lflaherty/evfirmware-vcu/hardware/PCB_Layers/ECU_brd_layer1.pdf

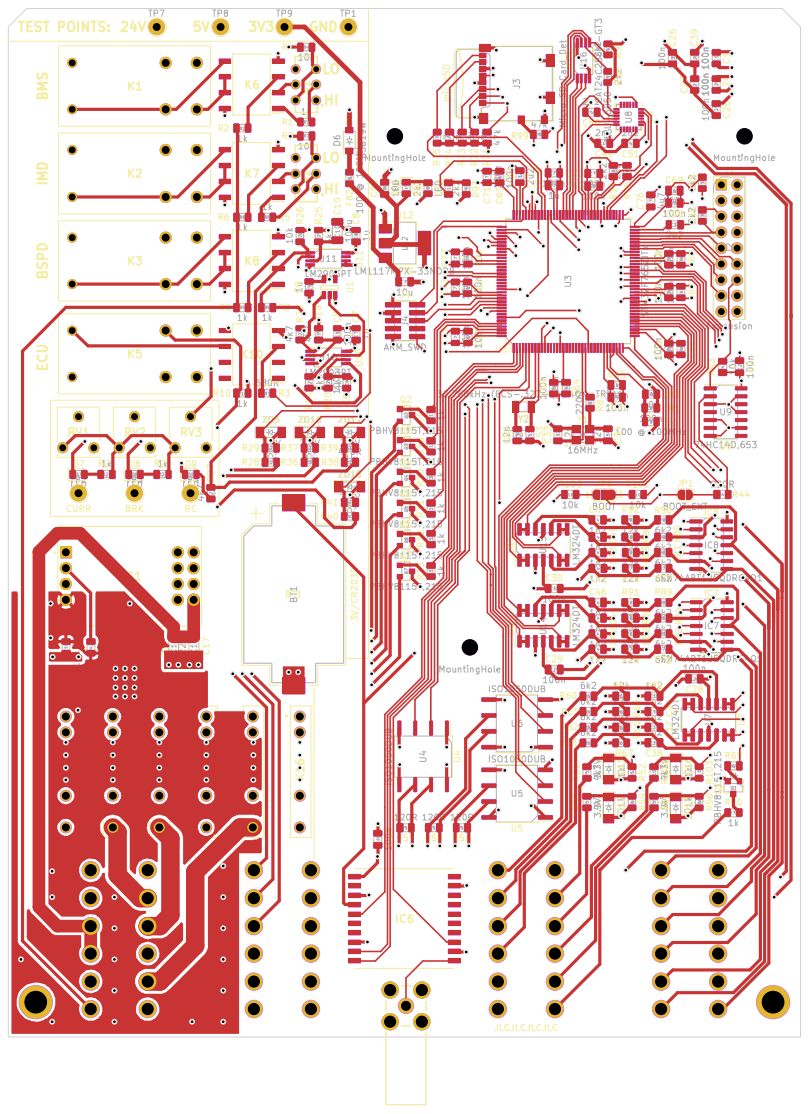
[picture p50: page 1]
