lflaherty/evfirmware-vcu/hardware/PCB_Layers/ECU_brd_layer2.pdf

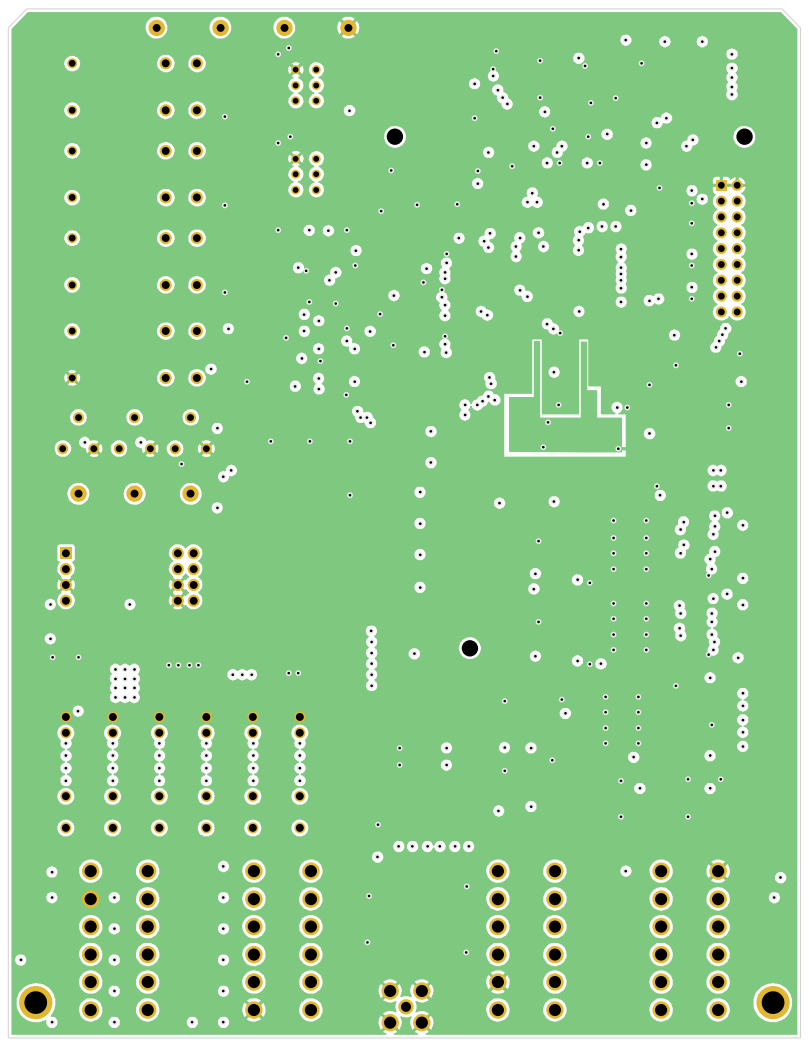
[picture p51: page 1]
