lflaherty/evfirmware-vcu/hardware/PCB_Layers/ECU_brd_layer3.pdf

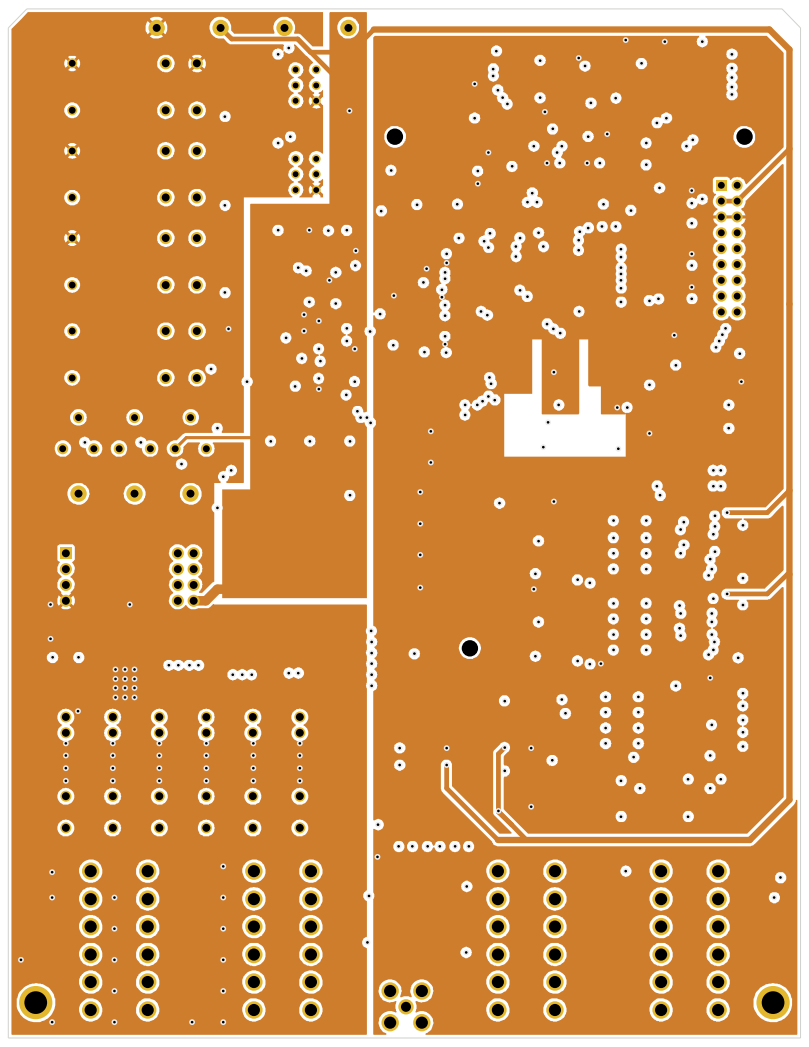
[picture p52: page 1]
