lflaherty/evfirmware-vcu/hardware/PCB_Layers/ECU_brd_layer4.pdf

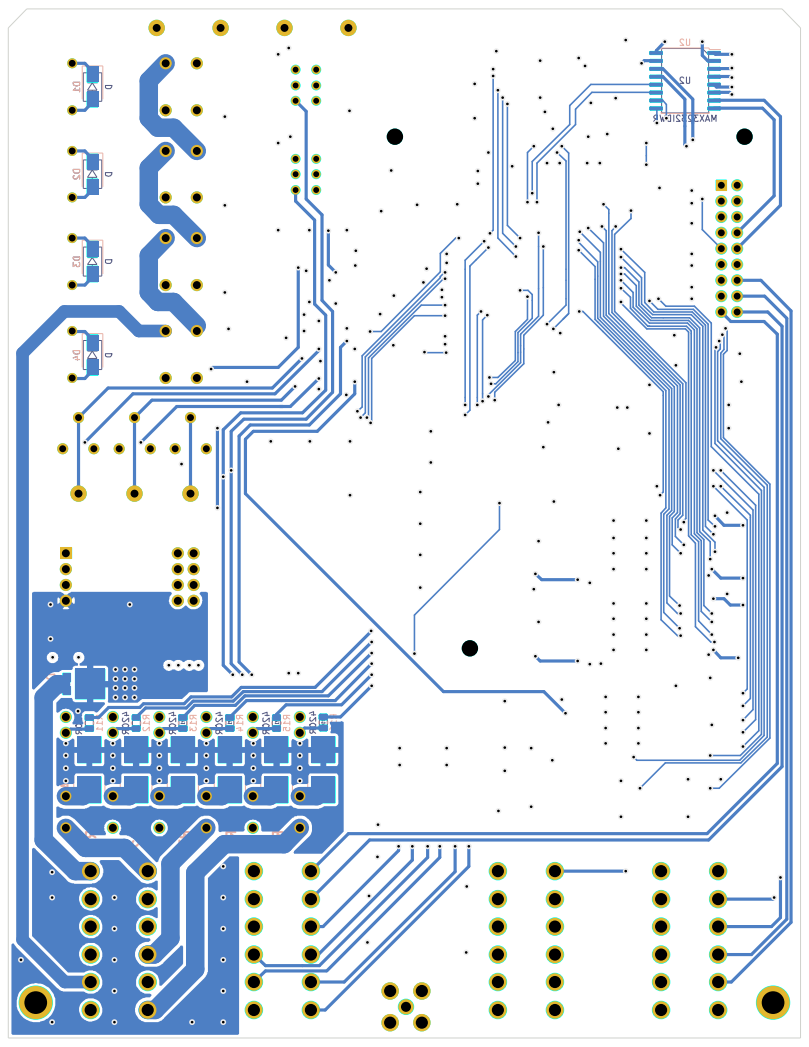
[picture p53: page 1]
