lflaherty/evfirmware-vcu/hardware/PCB_Layers/ECU_brd_combined.pdf

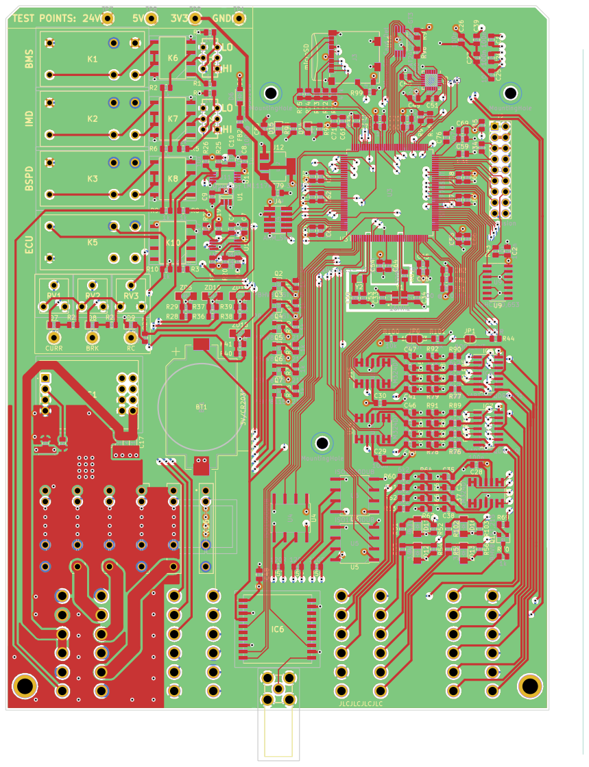
[picture p54: page 1]
