lflaherty/evfirmware-vcu/firmware/src/hal/stm32f767/Core/Src/main.c

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
/* Includes ------------------------------------------------------------------*/
#include "main.h"

/* USER CODE BEGIN Includes */
#include <stdio.h>
#include <stdbool.h>
#include "FreeRTOS.h"
#include "task.h"

#include "startup/initialize.h"

#include "logging/logging.h"

/* USER CODE END Includes */

ADC_HandleTypeDef hadc1;
DMA_HandleTypeDef hdma_adc1;

CAN_HandleTypeDef hcan1;
CAN_HandleTypeDef hcan2;
CAN_HandleTypeDef hcan3;

CRC_HandleTypeDef hcrc;

I2C_HandleTypeDef hi2c2;
I2C_HandleTypeDef hi2c4;
DMA_HandleTypeDef hdma_i2c2_tx;
DMA_HandleTypeDef hdma_i2c2_rx;

RTC_HandleTypeDef hrtc;

TIM_HandleTypeDef htim2;
TIM_HandleTypeDef htim3;

UART_HandleTypeDef huart1;
UART_HandleTypeDef huart3;
UART_HandleTypeDef huart6;
DMA_HandleTypeDef hdma_usart1_rx;
DMA_HandleTypeDef hdma_usart1_tx;
DMA_HandleTypeDef hdma_usart3_rx;
DMA_HandleTypeDef hdma_usart3_tx;
DMA_HandleTypeDef hdma_usart6_rx;
DMA_HandleTypeDef hdma_usart6_tx;

/* USER CODE BEGIN PV */
static InitData_T initData;
/* USER CODE END PV */

void SystemClock_Config(void);
static void MX_GPIO_Init(void);
static void MX_ADC1_Init(void);
static void MX_CAN1_Init(void);
static void MX_CAN2_Init(void);
static void MX_CAN3_Init(void);
static void MX_I2C4_Init(void);
static void MX_USART1_UART_Init(void);
static void MX_USART3_UART_Init(void);
static void MX_I2C2_Init(void);
static void MX_USART6_UART_Init(void);
static void MX_RTC_Init(void);
static void MX_DMA_Init(void);
static void MX_TIM2_Init(void);
static void MX_CRC_Init(void);
static void MX_TIM3_Init(void);
/**
  * @brief  The application entry point.
  * @retval int
  */
int main(void)
{
  /* MCU Configuration--------------------------------------------------------*/

  /* Reset of all peripherals, Initializes the Flash interface and the Systick. */
  HAL_Init();

  /* Configure the system clock */
  SystemClock_Config();

  /* Initialize all configured peripherals */
  MX_GPIO_Init();
  MX_ADC1_Init();
  MX_CAN1_Init();
  MX_CAN2_Init();
  MX_CAN3_Init();
  MX_I2C4_Init();
  MX_USART1_UART_Init();
  MX_USART3_UART_Init();
  MX_I2C2_Init();
  MX_USART6_UART_Init();
  MX_RTC_Init();
  MX_DMA_Init();
  MX_TIM2_Init();
  MX_CRC_Init();
  MX_TIM3_Init();
  /* USER CODE BEGIN 2 */

  printf("\n");
  printf("Entering ECU_Init...\n");
  ECU_Init(&initData);

  /* USER CODE END 2 */

  /* Infinite loop */
  /* USER CODE BEGIN WHILE */
  while (1)
  {
    /* USER CODE END WHILE */

    /* USER CODE BEGIN 3 */
  }
  /* USER CODE END 3 */
}

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
/**
  * @brief  Period elapsed callback in non blocking mode
  * @note   This function is called  when TIM1 interrupt took place, inside
  * HAL_TIM_IRQHandler(). It makes a direct call to HAL_IncTick() to increment
  * a global variable "uwTick" used as application time base.
  * @param  htim : TIM handle
  * @retval None
  */
void HAL_TIM_PeriodElapsedCallback(TIM_HandleTypeDef *htim)
{
  if (htim->Instance == TIM1) {
    HAL_IncTick();
  }
  /* USER CODE BEGIN Callback 1 */

  // Board timer handlers
  TIM_IRQHandler(htim);

  /* USER CODE END Callback 1 */
}

/**
  * @brief  This function is executed in case of error occurrence.
  * @retval None
  */
void Error_Handler(void)
{
  /* USER CODE BEGIN Error_Handler_Debug */
  /* User can add his own implementation to report the HAL error return state */
  __disable_irq();
  while (1)
  {
  }
  /* USER CODE END Error_Handler_Debug */
}

#ifdef  USE_FULL_ASSERT
/**
  * @brief  Reports the name of the source file and the source line number
  *         where the assert_param error has occurred.
  * @param  file: pointer to the source file name
  * @param  line: assert_param error line source number
  * @retval None
  */
void assert_failed(uint8_t *file, uint32_t line)
{
  /* USER CODE BEGIN 6 */
  /* User can add his own implementation to report the file name and line number,
     ex: printf("Wrong parameters value: file %s on line %d\r\n", file, line) */
  /* USER CODE END 6 */
}
#endif /* USE_FULL_ASSERT */
