lflaherty/evfirmware-vcu/firmware/src/hal/stm32f767/evfirmware-vcu.ioc

Mcu.UserName=STM32F767ZITx
PA0/WKUP.Signal=ADCx_IN0
PA1.Signal=ADCx_IN1
PA10.Signal=USART1_RX
PA11.GPIO_Label=SDMMC_DET
PA11.Signal=GPIO_Input
PA12.GPIO_Label=STATUS_LED
PA12.Signal=GPIO_Output
PA13.Signal=SYS_JTMS-SWDIO
PA14.Signal=SYS_JTCK-SWCLK
PA15.Signal=CAN3_TX
PA2.Signal=ADCx_IN2
PA3.Signal=ADCx_IN3
PA4.Signal=ADCx_IN4
PA5.Signal=ADCx_IN5
PA6.Signal=ADCx_IN6
PA7.Signal=ADCx_IN7
PA8.Signal=CAN3_RX
PA9.Signal=USART1_TX
PB0.Signal=ADCx_IN8
PB1.Signal=ADCx_IN9
PB12.GPIO_Label=MPIO_EN1
PB12.Signal=GPIO_Output
PB13.GPIO_Label=MPIO_OUT1
PB13.Signal=GPIO_Output
PB2.GPIO_Label=MPIO_EN2
PB2.Signal=GPIO_Output
PB3.Signal=SYS_JTDO-SWO
PB4.GPIO_Label=GPIO_EXTI4_SDCOUT
PB4.Signal=GPXTI4
PB5.Signal=CAN2_RX
PB6.Signal=CAN2_TX
PB9.GPIO_Label=P_SW1
PB9.Signal=GPIO_Output
PC14/OSC32_IN.Signal=RCC_OSC32_IN
PC15/OSC32_OUT.Signal=RCC_OSC32_OUT
PC4.Signal=ADCx_IN14
PC5.Signal=ADCx_IN15
PC6.GPIO_Label=MPIO_OUT8
PC6.Signal=GPIO_Output
PC7.Signal=USART6_RX
PD0.Signal=CAN1_RX
PD1.Signal=CAN1_TX
PD10.GPIO_Label=MPIO_EN4
PD10.Signal=GPIO_Output
PD11.GPIO_Label=MPIO_OUT4
PD11.Signal=GPIO_Output
PD12.Signal=I2C4_SCL
PD13.Signal=I2C4_SDA
PD14.GPIO_Label=IMU_INT
PD14.Signal=GPXTI14
PD15.GPIO_Label=IMU_ADDR0
PD15.Signal=GPIO_Output
PD4.GPIO_Label=ECU_SW_Error
PD4.Signal=GPIO_Output
PD8.Signal=USART3_TX
PD9.Signal=USART3_RX
PE0.GPIO_Label=P_SW2
PE0.Signal=GPIO_Output
PE1.GPIO_Label=P_SW3
PE1.Signal=GPIO_Output
PE10.GPIO_Label=MPIO_EN3
PE10.Signal=GPIO_Output
PE11.GPIO_Label=MPIO_OUT2
PE11.Signal=GPIO_Output
PE15.GPIO_Label=EXP_GPIO1
PE15.Signal=GPIO_Output
PE2.GPIO_Label=P_SW4
PE2.Signal=GPIO_Output
PE3.GPIO_Label=P_SW5
PE3.Signal=GPIO_Output
PE4.GPIO_Label=P_SW6
PE4.Signal=GPIO_Output
PE5.GPIO_Label=GPS_FIX
PE5.Signal=GPIO_Input
PE6.GPIO_Label=GPS_PPS
PE6.Signal=GPIO_Input
PE7.GPIO_Label=DIN_WS_F
PE7.Signal=GPIO_Input
PE8.GPIO_Label=MPIO_OUT3
PE8.Signal=GPIO_Output
PE9.GPIO_Label=DIN_START_B
PE9.Signal=GPIO_Input
PF0.Signal=I2C2_SDA
PF1.Signal=I2C2_SCL
PF11.GPIO_Label=MPIO_OUT7
PF11.Signal=GPIO_Output
PF12.GPIO_Label=DOUT_START_B
PF12.Signal=GPIO_Output
PF13.GPIO_Label=MPIO_EN7
PF13.Signal=GPIO_Output
PF14.GPIO_Label=DIN_INV_ERR
PF14.Signal=GPIO_Input
PF15.GPIO_Label=MPIO_OUT6
PF15.Signal=GPIO_Output
PG0.GPIO_Label=DIN_WS_R
PG0.Signal=GPIO_Input
PG1.GPIO_Label=MPIO_EN6
PG1.Signal=GPIO_Output
PG10.GPIO_Label=GPIO_EXTI10_SDCIMD
PG10.Signal=GPXTI10
PG14.Signal=USART6_TX
PG15.GPIO_Label=GPIO_EXTI15_SDCBSPD
PG15.Signal=GPXTI15
PG2.GPIO_Label=MPIO_EN5
PG2.Signal=GPIO_Output
PG3.GPIO_Label=MPIO_OUT5
PG3.Signal=GPIO_Output
PG4.GPIO_Label=EEPROM_ADDR2
PG4.Signal=GPIO_Output
PG5.GPIO_Label=EEPROM_ADDR1
PG5.Signal=GPIO_Output
PG6.GPIO_Label=EEPROM_ADDR0
PG6.Signal=GPIO_Output
PG7.GPIO_Label=EEPROM_WP
PG7.Signal=GPIO_Output
PG8.GPIO_Label=MPIO_EN8
PG8.Signal=GPIO_Output
PG9.GPIO_Label=GPIO_EXTI9_SDCBMS
PG9.Signal=GPXTI9
PH0/OSC_IN.Signal=RCC_OSC_IN
PH1/OSC_OUT.Signal=RCC_OSC_OUT
