lflaherty/evfirmware-vcu/firmware/src/vcu/startup/initialize.h

/*
 * initialize.h
 *
 *  Created on: 6 Oct 2021
 *      Author: Liam Flaherty
 */

#ifndef INC_INITIALIZE_H_
#define INC_INITIALIZE_H_

#include "stm32f7xx_hal.h"
#include <stdint.h>

typedef struct {
  // TODO actually use this, but this is just a placeholder for now
  uint32_t mcuResetReason;
} InitData_T;

/**
 * @brief Initializes "System" and "Application" components for this ECU and
 * starts scheduling.
 * This method invokes the RTOS scheduler, and should never exit.
 * 
 * @param initData Initial data from MCU used to init ECU
 */
void ECU_Init(const InitData_T* initData);

/**
 * @brief IRQ Handler for timer elapsed callback.
 * 
 * @param htim TIM event
 */
void TIM_IRQHandler(TIM_HandleTypeDef *htim);


#endif /* INC_INITIALIZE_H_ */
