lflaherty/evfirmware-vcu/firmware/src/vcu/startup/welcomemsg.c

#include <stddef.h>

const char* welcomeMsg = 
"####################################\n"
"#     ___                          #\n"
"#    /   \\                         #\n" 
"#   |] _ [|           DFEA         #\n"
"#   |_/ \\_|          RACING        #\n"
"#   / \\_/ \\                        #\n"
"#  ||     ||                       #\n"
"#  ||     ||      QUACKIN QUICK    #\n"
"#   \\_____/                        #\n"
"#   __   __                        #\n"
"#                                  #\n"
"####################################\n";
