lflaherty/evfirmware-vcu/firmware/test/mock/stm32_hal/MockStm32f7xx_hal_adc.h

/*
 * MockStm32f7xx_hal_adc.h
 * Some excerpts from stm32f7xx_hal_adc.h in STM32 HAL.
 *
 *  Created on: Oct 15 2021
 *      Author: Liam Flaherty
 */

#ifndef MOCK_STM32F7xx_ADC_H_
#define MOCK_STM32F7xx_ADC_H_

#include <stdint.h>
#include <stddef.h>
#include "MockStm32f7xx_hal_def.h"

#define MOCK_ADC_MAX_DATA 64

// ================== Define types ==================
typedef struct
{
    uint32_t DataAlign;
    uint32_t ContinuousConvMode;
    uint32_t NbrOfConversion;
} ADC_InitTypeDef;

typedef struct
{
    // Empty for mock
    uint8_t tmp;
} ADC_TypeDef;

typedef struct
{
    ADC_TypeDef* Instance;
    ADC_InitTypeDef Init;
} ADC_HandleTypeDef;

// These are supposed to be pointers to the peripherals, but for the purposes
// of the mock, unique numbers cast to a pointer will work fine.
// Don't dereference them...
#define ADC1 ((ADC_TypeDef*)0x0)


#define ADC_DATAALIGN_RIGHT      ((uint32_t)0x00000000U)


// ================== Define methods ==================
HAL_StatusTypeDef stubHAL_ADC_Start_DMA(ADC_HandleTypeDef* hadc, uint32_t* pData, uint32_t Length);

// Replace real methods with mock stubs
#define HAL_ADC_Start_DMA stubHAL_ADC_Start_DMA

// ================== Mock control methods ==================
void mockSetADCData(uint32_t* data, uint32_t dataLength);
void mockSetADCDataChannel(const uint32_t channel, const uint32_t val);
void mockClearADCClear(void);
void mockSet_HAL_ADC_Start_DMA_Status(HAL_StatusTypeDef status);

#endif
