lflaherty/evfirmware-vcu/(commit log)

2021-07-23 add ADC
2021-07-24 correct usage of printf
2021-07-24 change logging from printf to logging lib
2021-07-24 update SPI and AD5592R old code
2021-07-24 enlarged stack sizes to avoid stack overflow
    [can.h, uart.h]
2021-08-07 update pin mapping
2021-08-08 corrected ADC averaging function
    [adc.c]
2021-08-09 configurable number of adc channels
2021-08-14 changed timer counter to uint32_t
2021-08-15 update constants for new timer settings
2021-08-22 added test framework
2021-10-06 set up timers and interrupts
2021-10-06 add CAN busses
2021-10-07 udpate adc conversion channels
2021-10-07 adc mapping and initializatoin
2021-10-07 init timers and rtc
2021-10-07 remove static data storage for external devices
2021-10-07 move data storage for external devices to init obj
2021-10-07 add new inverter driver
2021-10-12 update test build process for correct mocking
    [TestCan.c]
2021-10-12 unnecessary print
2021-10-15 add ADC mock and test
2021-10-15 refactor to support sample size of 1
2021-10-15 add ADC tests
2021-10-15 multi-threaded build
2021-10-15 removed extra printf statements
2021-10-17 allow test system to be called from larger test framework
2021-10-20 move lib diagram to current repo to allow README to render
2022-05-01 Add timer tests
2022-05-05 remove external watchdog - device removed
2022-05-08 update STM32 HAL drivers
2022-05-14 add dash button input
2022-06-02 add test case to cover whole sequence
2022-06-07 renamed deviceMapping dir to config
2022-06-10 Add brake pressure calibration and redundant sensor fault checks
2022-06-22 add throttle controller
2022-06-24 state machine updates throttle controller modes
2022-07-10 Fix implicit integer conversions
    [MockStm32f7xx_hal_adc.c, MockStm32f7xx_hal_adc.h, TestCan.c, adc.c, can.c, can.h, uart.c, uart.h]
2022-07-19 added BMS fault checks
2022-07-26 create msgframe for creating packets on uart
2022-07-31 create serial message encoder
2022-08-01 handle ECU init errors
    [initialize.c]
2022-08-02 add status LED & init code
2022-08-03 create driver module for debug PC
2022-08-07 create mock for printf
2022-08-11 implement uart interface
2022-08-14 implement log output on serial with message frames
2022-08-14 add printing of received bytes
2022-08-14 remove logging timer counter - task scheulding at 100ms is ok
2022-08-14 remove interrupt disable
2022-08-16 remove unused device handle
2022-09-05 fix DMA init order
    [main.c]
2022-09-28 Re-implement CAN driver/interface to allow queueing of pending messages when tx hardware is busy
2022-10-08 fix initialization of serial ports
    [initialize.c]
2022-10-08 usart3: enable interrupt, enable dma Disable code generation of SVC_Handler, PendSV_Handler, and SysTick_Handler
2022-10-15 move STM32CubeIDE build to virtual path to avoid using symlink for firmware build. This allows CubeIDE to compile on Windows
2022-10-15 enable CAN1 TX and RX1 interrupts
2022-11-06 reworked test suites to use CMake and produce separate binaries for more scalable mocking
    [MockThrottleController.h, MockVehicleControl.h, TestFaultManager.c, TestPCDebug.c, TestThrottleController.c]
2022-11-13 add shutdown circuit driver
2022-11-19 add Power Distribution Module (PDM) driver
2022-11-20 rename PCDebug driver to PCInterface
2022-11-20 add missing depends to gps
    [gps.c]
2022-12-09 fix typo & add dependency support
    [MockVehicleControl.c, TestVehicleControl.c]
2022-12-09 implement SDC ECU error output control from vehicle control interface
    [MockVehicleControl.c, TestVehicleControl.c]
2022-12-11 add support for debug message requests and SDC/ECU error control message
    [MockVehicleControl.c, MockVehicleControl.h, TestPCInterface.c, messages.h, pcinterface.c, pcinterface.h, requests.c]
2022-12-24 add USART6 interrupt
2022-12-28 refactor task timer to remove diver and use one hardware timer per frequency
2022-12-31 add debug toggle pin
2022-12-31 add GPIO toggle pin
2022-12-31 fix hardware timer to expire at 100Hz
    [evfirmware-vcu.ioc, main.c]
2023-01-27 move timer handling code out of auto generated cube-proj directory
2023-01-29 add wheel speed sensor driver
2023-01-29 removed SPI expansion bus and disable SPI interface from build
2023-03-23 add wheelspeed driver init
2023-03-24 remove reverse driving state
    [TestVehicleStateMachine.c]
2023-03-24 add control of ECU error bit from state machine
    [TestVehicleStateMachine.c]
2023-03-24 refactor inverter driver to use new CAN and VehicleState methods
2023-03-31 add missing ISRs and fix Rx mock
    [MockStm32f7xx_hal_can.c, MockStm32f7xx_hal_can.h]
2023-04-01 add inverter driver test and update issues arising from tests
    [TestCInverter.c, TestVehicleStateMachine.c, cInverter.c, cInverter.h, cInverterCAN.h, dataConversions.h]
2023-04-10 add init message and fix task timer init
    [initialize.c]
2023-04-10 add DMA channel for USART 6 and fix DMA interrupt priorities to allow FreeRTOS usage
    [evfirmware-vcu.ioc, main.c]
2023-04-15 refactor init code to: be easier to read; init hangs work by calling infinite loop rather than returning; init data can be passed to application init methods (this is for data such as reset reason wh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
    [initialize.c, initialize.h, main.c]
2023-04-15 update mock to support all UART interfaces and IRQ methods
2023-04-15 refactor UART to remove STM32 HAL types from external API, fix Tx method to disable interrupts before accessing shared varible with ISR
    [TestUart.c, uart.c, uart.h]
2023-04-15 update code depending on UART to support updated UART API
2023-04-15 rename rxIrq -> txIrq fixing typo, the TX interrupt must be paused when entering the UART_SendMessage critical section
    [TestUart.c, uart.c, uart.h]
2023-04-15 add Orion BMS CAN bus driver
2023-04-16 update BMS init and add to MCU init method
2023-04-16 update CAN rx filter to have one per bus and accept all CAN frames
2023-04-16 enable CAN2 and CAN3 interrupts
2023-04-21 update CAN IDs to fit within 11 bits and transmit BMS state on pc interface
2023-04-22 increase UART DMA buffer length
2023-04-25 update BMS value scaling to conform with BMS datasheet, remove unused conversion functions
2023-05-07 increase test case coverage
2023-05-07 move method to where it used, and avoid unused warning for static method
    [debugterm.c, debugtermlib.h]
2023-05-20 re-implement ADC DMA to correctly use half complete interrupts via a triple buffer system
    [MockStm32f7xx_hal_adc.h, TestAdc.c, adc.c, adc.h]
2023-05-20 fix ADC handling switching to copy buffer B and add unit test to cover taking multiple samples
    [TestAdc.c, adc.c]
2023-05-21 add ADC scaling helper method and convert ADC_Channel_T to explicit enum
2023-05-21 improved ADC mock handling of data lengths
2023-05-21 add data valid checking to make sure data isn't accessed before DMA complete callbacks have run
2023-05-21 add discrete sense task for uniform sampling of ADC and GPIO inputs
2024-01-26 add I2C; refactor semaphore mock to support multiple semaphores
2024-01-26 add i2c; update test support for new semaphore mock API
2024-02-28 add ECU schematic and PCB layout visualization
2024-02-28 update PCB images
2024-03-01 re-print schematic with correct CAN order
2024-03-11 remove debugging print statement
2024-03-11 add brackets and slashes to regex
2024-05-12 fix broken schematic link
2024-05-13 fix post merge to make tests pass
    [TestVehicleControl.c]
2024-05-13 switch VCU src path
2024-05-14 fix broken semaphore call
    [i2c.c]
2024-08-10 add arm-none-eabi-gcc dependency
